dazed-16/Tactile/BOM.md

# Tactile – bill of materials

<!-- Generated by Half Life from project cmuvi96ii00q001opnk86sqve. Edits here are overwritten on the next sync. -->
<!-- Generated: 2026-10-12T03:10:27.600Z -->

> [!NOTE]
> This parts list is mirrored from [Half Life](https://halflife.hackclub.com). Editing it here will not change the platform's copy, and the next sync overwrites this file.

| Week | Tier | Parts funding |
| --- | --- | --- |
| Week 1 | Tier 2 | $65.00 |

| Part | What it's for | Qty | Unit | Total | Vendor |
| --- | --- | --- | --- | --- | --- |
| [BLE controller](https://www.seeedstudio.com/Seeed-XIAO-BLE-nRF52840-p-5201.html) | — | 1 | $9.90 | $9.90 | [Seeedstudio](https://www.seeedstudio.com/Seeed-XIAO-BLE-nRF52840-p-5201.html) |
| [Tactile switches](https://en.akkogear.com/product/creamy-purple-u1-switch/) | — | 2 | $9.99 | $19.98 | [Akkogear](https://en.akkogear.com/product/creamy-purple-u1-switch/) |
| [Touchpad](https://www.mouser.com/en/ProductDetail/Cirque/TM040040-2024-302?qs=wd5RIQLrsJgMzmw571gvDw%3D%3D) | — | 1 | $9.63 | $9.63 | [Mouser](https://www.mouser.com/en/ProductDetail/Cirque/TM040040-2024-302?qs=wd5RIQLrsJgMzmw571gvDw%3D%3D) |
| [Matrix diodes](https://www.digikey.com/en/products/detail/diodes-incorporated/1N4148W-7-F/815280) | — | 100 | $0.07 | $7.00 | [DigiKey](https://www.digikey.com/en/products/detail/diodes-incorporated/1N4148W-7-F/815280) |
| [Shift registers](https://www.digikey.com/en/products/detail/nexperia-usa-inc/74HC595D-118/763394) | — | 2 | $0.30 | $0.60 | [DigiKey](https://www.digikey.com/en/products/detail/nexperia-usa-inc/74HC595D-118/763394) |
| [Capacitors](https://www.digikey.com/en/products/detail/yageo/CC0805KRX7R9BB104/302874) | — | 10 | $0.10 | $1.00 | [DigiKey](https://www.digikey.com/en/products/detail/yageo/CC0805KRX7R9BB104/302874) |
| [Touchpad connector](https://www.digikey.com/en/products/detail/hirose-electric-co-ltd/FH12-12S-0-5SH-55/1110316) | — | 1 | $2.00 | $2.00 | [DigiKey](https://www.digikey.com/en/products/detail/hirose-electric-co-ltd/FH12-12S-0-5SH-55/1110316) |
| [Touchpad cable](https://www.digikey.com/en/products/detail/assmann-wsw-components/AFFC-050-12-051-11/6570261) | — | 1 | $2.00 | $2.00 | [DigiKey](https://www.digikey.com/en/products/detail/assmann-wsw-components/AFFC-050-12-051-11/6570261) |
| [Ribbon cable](https://www.digikey.com/en/products/detail/assmann-wsw-components/AWG28-14-F-300/655738) | — | 2 | $1.79 | $3.58 | [DigiKey](https://www.digikey.com/en/products/detail/assmann-wsw-components/AWG28-14-F-300/655738) |
| [IDC sockets](https://www.digikey.com/en/products/detail/assmann-wsw-components/AWP-14-8240-T/5244612) | — | 2 | $0.60 | $1.20 | [DigiKey](https://www.digikey.com/en/products/detail/assmann-wsw-components/AWP-14-8240-T/5244612) |
| [IDC strain reliefs](https://www.digikey.com/en/products/base-product/assmann-wsw-components/123/AWZ/567962) | — | 2 | $0.10 | $0.20 | [DigiKey](https://www.digikey.com/en/products/base-product/assmann-wsw-components/123/AWZ/567962) |
| [IDC headers](https://www.digikey.com/en/products/detail/assmann-wsw-components/AWHW-14G-0202-T/5224931) | — | 2 | $0.63 | $1.26 | [DigiKey](https://www.digikey.com/en/products/detail/assmann-wsw-components/AWHW-14G-0202-T/5224931) |
| [Power switch](https://www.digikey.com/en/products/detail/e-switch/EG1218/101726) | — | 1 | $0.72 | $0.72 | [DigiKey](https://www.digikey.com/en/products/detail/e-switch/EG1218/101726) |
| [Battery protection IC](https://www.ti.com/product/BQ2970) | — | 1 | $1.00 | $1.00 | [TI](https://www.ti.com/product/BQ2970) |
| [Dual MOSFET](https://www.ti.com/product/CSD83325L) | — | 1 | $1.50 | $1.50 | [TI](https://www.ti.com/product/CSD83325L) |
| 330 ohm resistor | — | 1 | $0.10 | $0.10 | — |
| 2.2 kOhm resistor | — | 1 | $0.10 | $0.10 | — |
| [Battery connector](https://www.jst-mfg.com/product/index.php?series=ACH) | — | 1 | $0.50 | $0.50 | [Jst-mfg](https://www.jst-mfg.com/product/index.php?series=ACH) |
| **Parts subtotal** | — | — | — | **$62.27** | — |
| **Tax & shipping** | — | — | — | **$0.00** | — |
| **Total** | — | — | — | **$62.27** | — |

$2.73 left of the tier's funding.
