dazed-16/Tactile/Tactile/Model/Leftside.stl

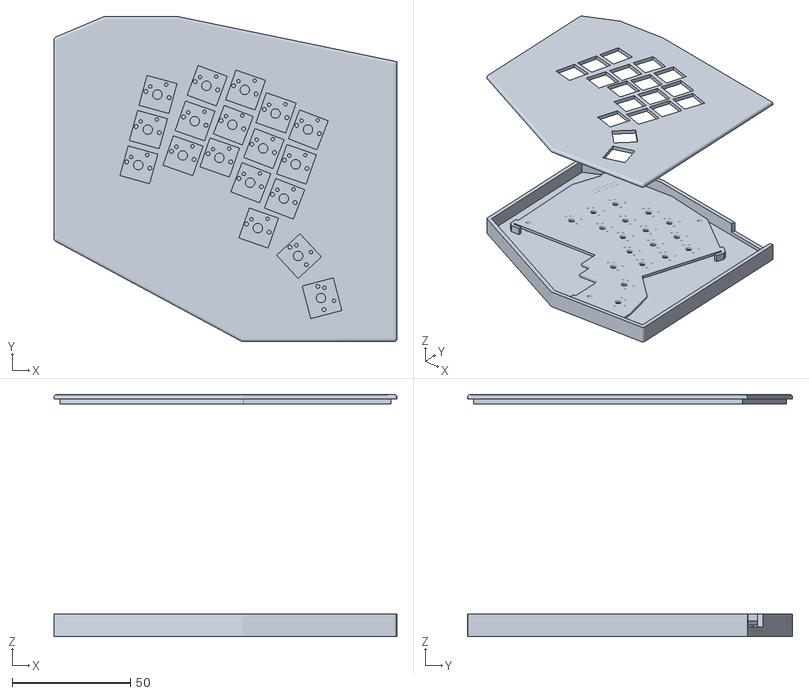
[picture p6: CAD file, 2026-10-12]
Tactile/Model/Leftside.stl
145.2 x 137.6 x 102.5
