dazed-16/Tactile/Tactile/Model/Right side.stl

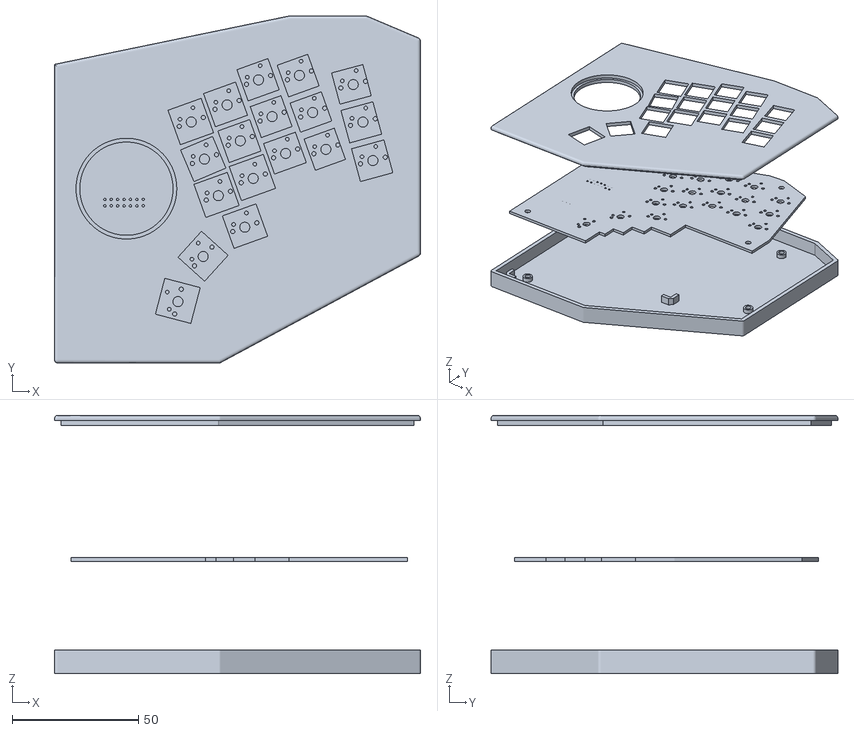
[picture p7: CAD file, 2026-10-12]
Tactile/Model/Right side.stl
145.2 x 137.6 x 102.5
