dazed-16/Tactile/Tactile/PCB/Left side/Tactile-l.kicad_pcb

## KiCad design Tactile/PCB/Left side/Tactile-l.kicad_pcb (2026-10-12)

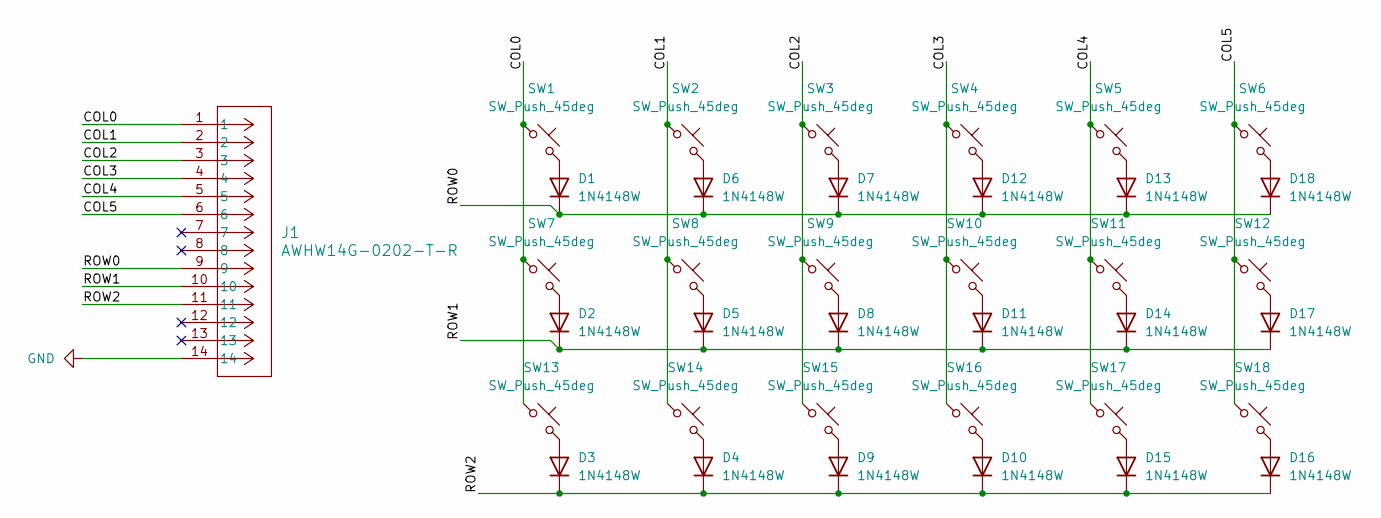
[picture p8: schematic Tactile-l.kicad_sch]

Parts:
D1, D2, D3, D4, D5, D6, D7, D8, D9, D10, D11, D12, D13, D14, D15, D16, D17, D18: 1N4148W; D_SOD-123
J1: AWHW14G-0202-T-R; CONN_AWHW14G-0x02-T_ASM
SW1, SW2, SW3, SW4, SW5, SW6, SW7, SW8, SW9, SW10, SW11, SW12, SW13, SW14, SW15, SW16, SW17, SW18: SW_Push_45deg; Knowles_SPH0645LM4H-6_3.5x2.65mm

Connections:
/COL0: J1.1, SW1.1, SW7.1, SW13.1
/COL1: J1.2, SW2.1, SW8.1, SW14.1
/COL2: J1.3, SW3.1, SW9.1, SW15.1
/COL3: J1.4, SW4.1, SW10.1, SW16.1
/COL4: J1.5, SW5.1, SW11.1, SW17.1
/COL5: J1.6, SW6.1, SW12.1, SW18.1
/ROW0: D1.1 (K), D6.1 (K), D7.1 (K), D12.1 (K), D13.1 (K), D18.1 (K), J1.9
/ROW1: D2.1 (K), D5.1 (K), D8.1 (K), D11.1 (K), D14.1 (K), D17.1 (K), J1.10
/ROW2: D3.1 (K), D4.1 (K), D9.1 (K), D10.1 (K), D15.1 (K), D16.1 (K), J1.11
GND: J1.14
unnamed: D1.2 (A), SW1.2
unnamed: D2.2 (A), SW7.2
unnamed: D3.2 (A), SW13.2
unnamed: D4.2 (A), SW14.2
unnamed: D5.2 (A), SW8.2
unnamed: D6.2 (A), SW2.2
unnamed: D7.2 (A), SW3.2
unnamed: D8.2 (A), SW9.2
unnamed: D9.2 (A), SW15.2
unnamed: D10.2 (A), SW16.2
unnamed: D11.2 (A), SW10.2
unnamed: D12.2 (A), SW4.2
unnamed: D13.2 (A), SW5.2
unnamed: D14.2 (A), SW11.2
unnamed: D15.2 (A), SW17.2
unnamed: D16.2 (A), SW18.2
unnamed: D17.2 (A), SW12.2
unnamed: D18.2 (A), SW6.2

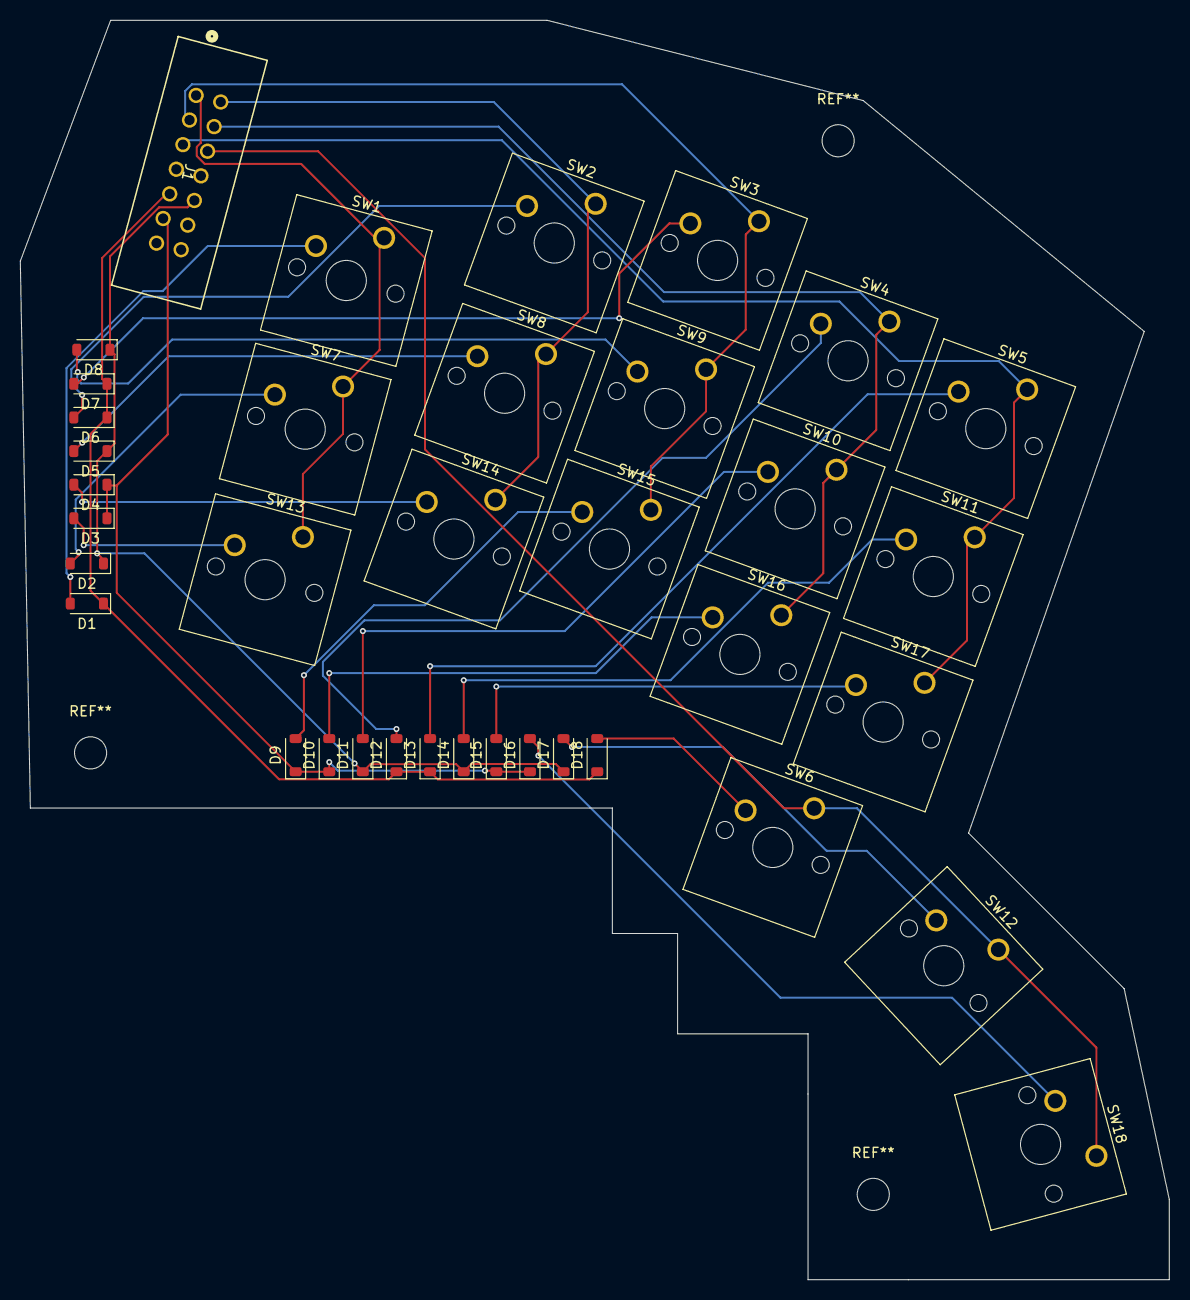
[picture p9: board Tactile-l.kicad_pcb from above]

Board: 2 copper layers, 114.5 x 125.5 mm, 37 parts (0 on the bottom side), 27 nets.
