dazed-16/Tactile/Tactile/PCB/Right side/Tactile-r.kicad_pcb

## KiCad design Tactile/PCB/Right side/Tactile-r.kicad_pcb (2026-10-12)

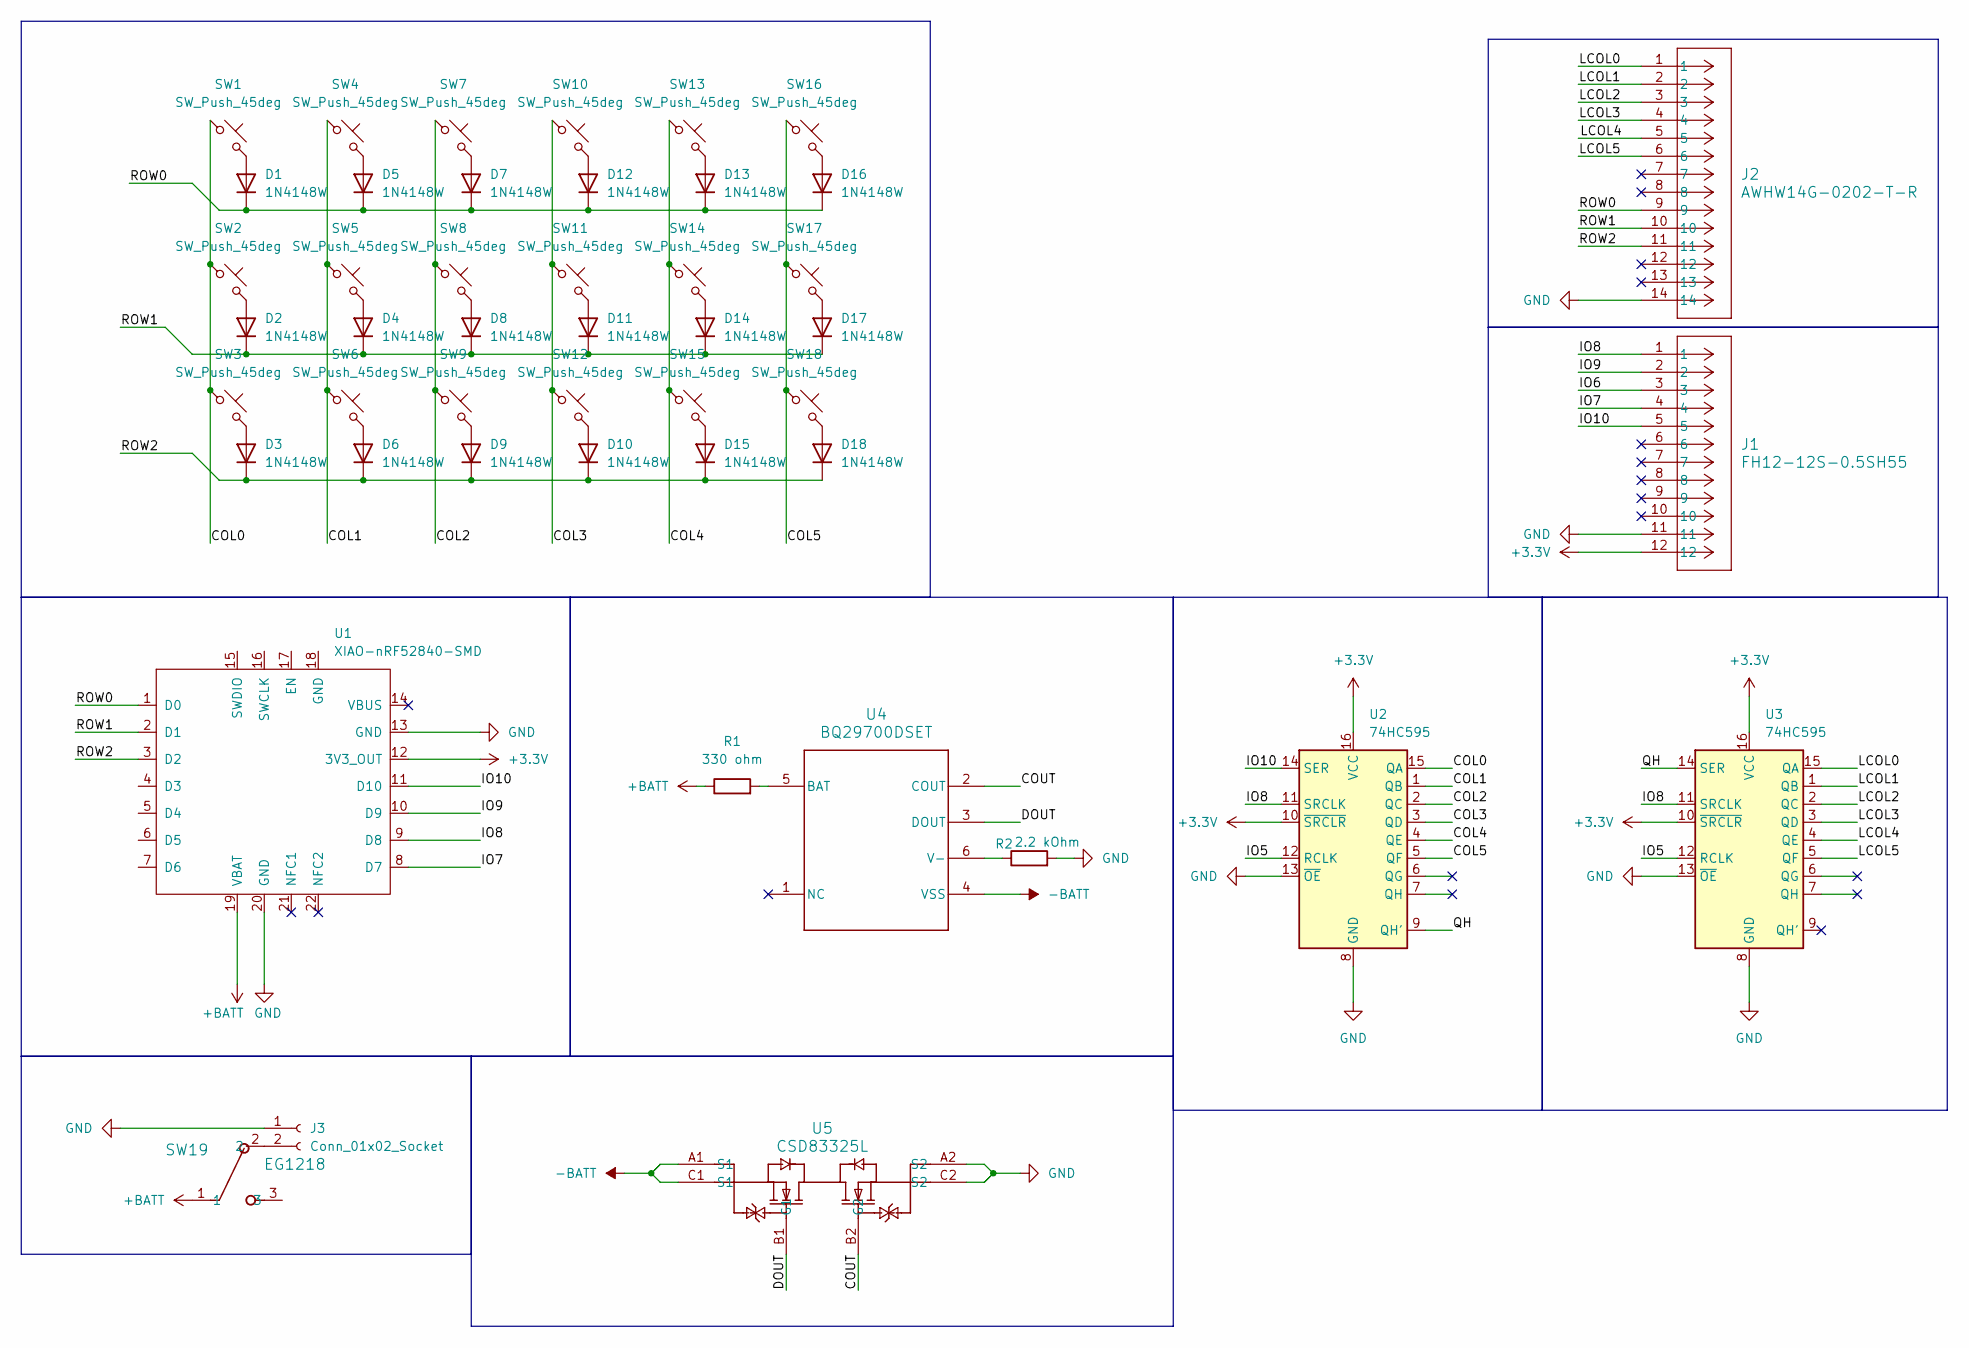
[picture p10: schematic Tactile-r.kicad_sch]

Parts:
D1, D2, D3, D4, D5, D6, D7, D8, D9, D10, D11, D12, D13, D14, D15, D16, D17, D18: 1N4148W; D_SOD-123
J1: FH12-12S-0.5SH55; CONN_FH12-12S-0.5SH55_HIR
J2: AWHW14G-0202-T-R; CONN_AWHW14G-0x02-T_ASM
J3: Conn_01x02_Socket; JST_ACH_BM02B-ACHSS-GAN-ETF_1x02-1MP_P1.20mm_Vertical
R1: 330 ohm; R_0603_1608Metric
R2: 2.2 kOhm; R_0603_1608Metric
SW1, SW2, SW3, SW4, SW5, SW6, SW7, SW8, SW9, SW10, SW11, SW12, SW13, SW14, SW15, SW16, SW17, SW18: SW_Push_45deg; SW_Cherry_MX_1.00u_PCB
SW19: EG1218; SW_1218_EWI
U1: XIAO-nRF52840-SMD; XIAO-nRF54LM20A-SMD
U2, U3: 74HC595; SSOP-16_5.3x6.2mm_P0.65mm
U4: BQ29700DSET; DSE0006A
U5: CSD83325L; YJE0006A

Connections:
+3.3V: J1.12, U1.12 (3V3_OUT), U2.10 (~SRCLR), U2.16 (VCC), U3.10 (~SRCLR), U3.16 (VCC)
+BATT: R1.1, SW19.1, U1.19 (VBAT)
-BATT: U4.4 (VSS), U5.A1 (S1), U5.C1 (S1)
/<NO NET>: J2.3, U3.2 (QC)
/COL0: SW1.1, SW2.1, SW3.1, U2.15 (QA)
/COL1: SW4.1, SW5.1, SW6.1, U2.1 (QB)
/COL2: SW7.1, SW8.1, SW9.1, U2.2 (QC)
/COL3: SW10.1, SW11.1, SW12.1, U2.3 (QD)
/COL4: SW13.1, SW14.1, SW15.1, U2.4 (QE)
/COL5: SW16.1, SW17.1, SW18.1, U2.5 (QF)
/COUT: U4.2 (COUT), U5.B2 (G2)
/DOUT: U4.3 (DOUT), U5.B1 (G1)
/IO5: U2.12 (RCLK), U3.12 (RCLK)
/IO6: J1.3
/IO7: J1.4, U1.8 (D7)
/IO8: J1.1, U1.9 (D8), U2.11 (SRCLK), U3.11 (SRCLK)
/IO9: J1.2, U1.10 (D9)
/IO10: J1.5, U1.11 (D10), U2.14 (SER)
/LCOL0: J2.1, U3.15 (QA)
/LCOL1: J2.2, U3.1 (QB)
/LCOL3: J2.4, U3.3 (QD)
/LCOL4: J2.5, U3.4 (QE)
/LCOL5: J2.6, U3.5 (QF)
/QH: U2.9 (QH'), U3.14 (SER)
/ROW0: D1.1 (K), D5.1 (K), D7.1 (K), D12.1 (K), D13.1 (K), D16.1 (K), J2.9, U1.1 (D0)
/ROW1: D2.1 (K), D4.1 (K), D8.1 (K), D11.1 (K), D14.1 (K), D17.1 (K), J2.10, U1.2 (D1)
/ROW2: D3.1 (K), D6.1 (K), D9.1 (K), D10.1 (K), D15.1 (K), D18.1 (K), J2.11, U1.3 (D2)
GND: J1.11, J2.14, J3.1, R2.2, U1.13 (GND), U1.20 (GND), U2.8 (GND), U2.13 (~OE), U3.8 (GND), U3.13 (~OE), U5.A2 (S2), U5.C2 (S2)
unnamed: D1.2 (A), SW1.2
unnamed: D2.2 (A), SW2.2
unnamed: D3.2 (A), SW3.2
unnamed: D4.2 (A), SW5.2
unnamed: D5.2 (A), SW4.2
unnamed: D6.2 (A), SW6.2
unnamed: D7.2 (A), SW7.2
unnamed: D8.2 (A), SW8.2
unnamed: D9.2 (A), SW9.2
unnamed: D10.2 (A), SW12.2
unnamed: D11.2 (A), SW11.2
unnamed: D12.2 (A), SW10.2
unnamed: D13.2 (A), SW13.2
unnamed: D14.2 (A), SW14.2
unnamed: D15.2 (A), SW15.2
unnamed: D16.2 (A), SW16.2
unnamed: D17.2 (A), SW17.2
unnamed: D18.2 (A), SW18.2
unnamed: J3.2, SW19.2
unnamed: R1.2, U4.5 (BAT)
unnamed: R2.1, U4.6 (V-)

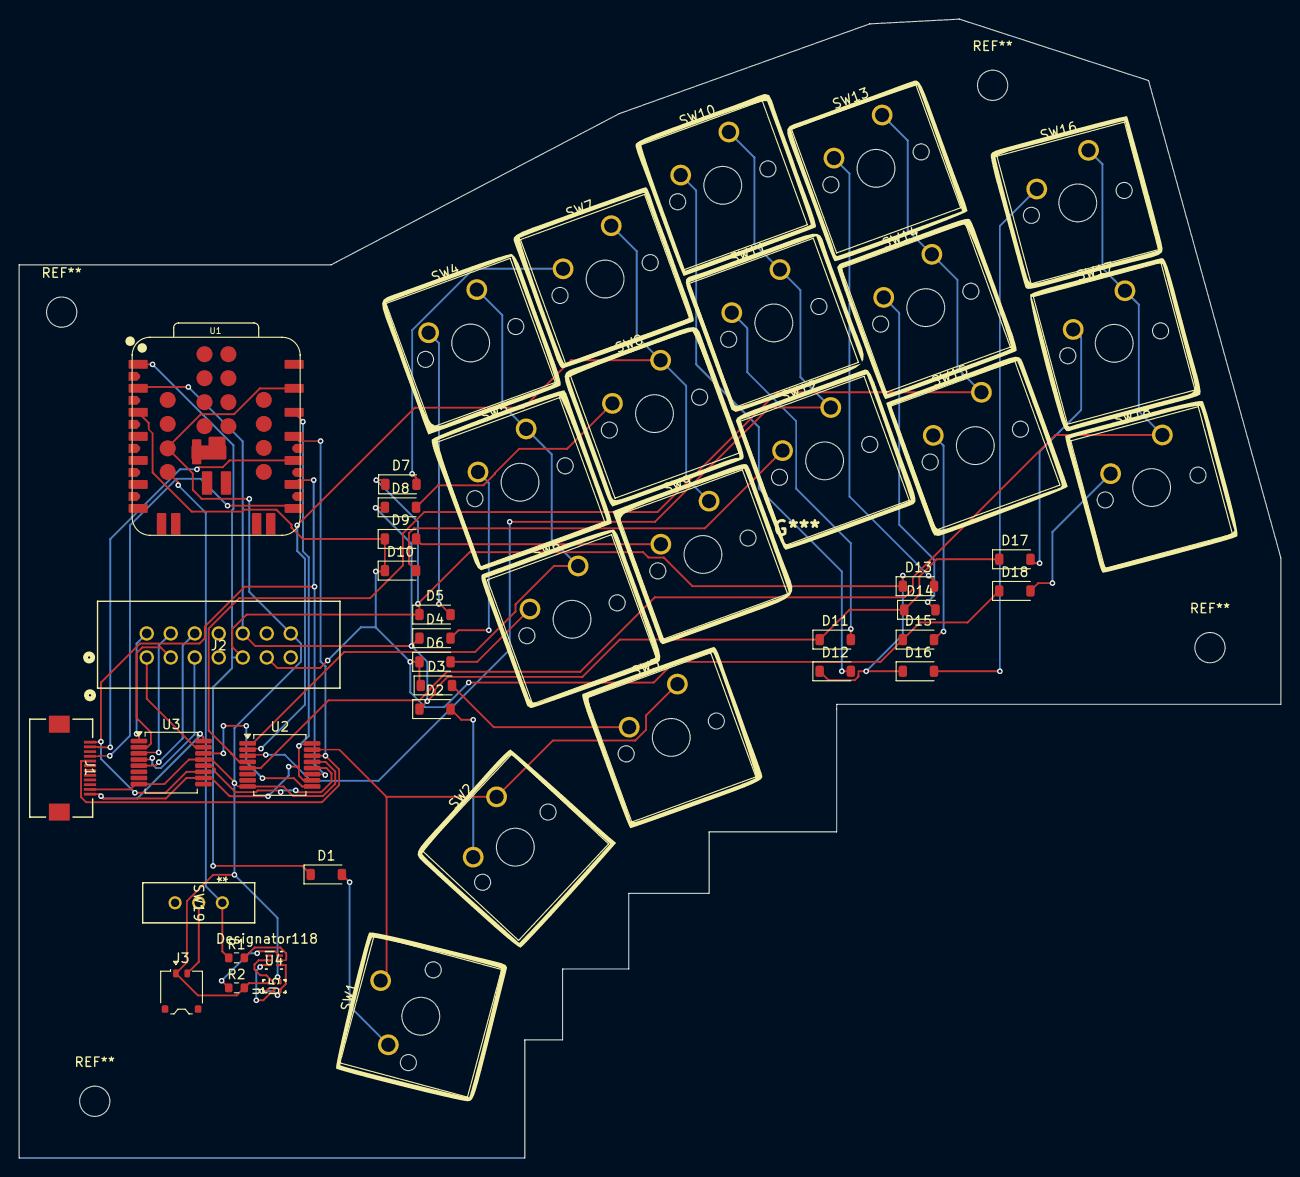
[picture p11: board Tactile-r.kicad_pcb from above]

Board: 2 copper layers, 133.5 x 120.5 mm, 47 parts (0 on the bottom side), 48 nets.
