dazed-16/Tactile/JOURNAL.md

# Tactile – devlog

<!-- Generated by Half Life from project cmuvi96ii00q001opnk86sqve. Edits here are overwritten on the next sync. -->
<!-- Generated: 2026-10-12T02:54:46.351Z -->

> [!NOTE]
> This devlog is mirrored from [Half Life](https://halflife.hackclub.com). Editing it here will not change the platform's copy, and the next sync overwrites this file.

> Tactile is a custom split mechanical keyboard for programming, live coding and CAD, with a thumb touchpad for pointer control.

| Week | Tier | Hours logged | Entries |
| --- | --- | --- | --- |
| Week 1 | Tier 2 | 14h | 6 |

## Contents

1. [2026-10-07 – # JOURNAL NUM1!!!!!](#2026-10-07-journal-num1)
2. [2026-10-08 – # CHECKPOINT NUM 2!!!!](#2026-10-08-checkpoint-num-2)
3. [2026-10-10 – # CHECKPOINT 3!!!!!!!!!](#2026-10-10-checkpoint-3)
4. [2026-10-11 – # CHECKPOINT NUM 4](#2026-10-11-checkpoint-num-4)
5. [2026-10-11 – # CHECKPOINT NUM 5](#2026-10-11-checkpoint-num-5)
6. [2026-10-11 – # LAST ONE!](#2026-10-11-last-one)

## Design

### 2026-10-07 – # JOURNAL NUM1!!!!!

**2h**

# JOURNAL NUM1!!!!!
Ok so kind of late to the party since school is just getting bussy, but here is a little overview of what I did here.
+ I rounded my price point to 65$ as a starting point
+ Generated a few of the components
+ Chose a few components that are economically viable

Ok so the real issue here is price of hour works, since I dont think I can do 20 hours in these 4 days, I might be able to undo a few of my ideas to the "essence" of the project. This includes, split keyboard, mouse integrated, and clicky keycaps. I also designed a nice setup for my hands!

bom

keyboard

### 2026-10-08 – # CHECKPOINT NUM 2!!!!

**2h**

# CHECKPOINT NUM 2!!!!
Okay so this is half of the keyboard done I chose the layout that seemed most attractive and comfortable, for me, I also made the schematic and PCB, of the left half, on checkpoint one I planned the most budget friendly option. Here is what I did today!
+ Chose keyboard layout
+ Schematic of left side
+ PCB of left side

I designed so the left side pretty much just connects like a controller to the right side, the right side has the battery, micro controller and usb connection so that will take me longer.

check1

### What I had problems with?
Its my first time making a keyboard, not only the format so I had some trouble working the footprints and silkscreen but I think it looks good, I am also going to see if someone can help me design a few mounting holes for the pcb since Ive never done accurate edgecuts apart from a simple cube

left

### 2026-10-10 – # CHECKPOINT 3!!!!!!!!!

**3h**

# CHECKPOINT 3!!!!!!!!!
Okay so the right side is FINALLY FINISHED, it took SOOOOOOOOOOOOOOOOOOOOOOOOO long, I swear I feel like im cutting myself short just logging 3 hours, but anyways, everything has been finished, and I am working on the documentation.

check3
## What I did today
+ Researched requirements for the left side (budget version)
+ Made schematic
+ Made PCB
+ Made documentation and updated BOM

check4
### What I struggled with?
Honestly it was a bit of a smooth ride now that I am getting the hang of making the keyboard, but the documentation was super crazy, some parts were way too expensive for the 13 hour goal I had, so I modified the plan to use the parts that I have on hand.

check5

### 2026-10-11 – # CHECKPOINT NUM 4

**4h**

# CHECKPOINT NUM 4
Okayyyyyy this was a big one, I made a lot of changes including the pcb, model and now 3d printed encasing?!?!?!?!? Yes you heard me this is what I did!
+ Modified edgecuts
+ Made 3d model
+ Made encasing
+ Tested,reiterated, repeated

check4

right side3
## What I strugled with?
I had some issues since its been so long since ive used, onshape, same thing with the edgecuts I dont like the geometry at all, it is kinda all over the place

rightside2
### What I might change?
In the future I might change the edgecuts and make the casing better.

right side

### 2026-10-11 – # CHECKPOINT NUM 5

**2h**

# CHECKPOINT NUM 5
Just finished the left side time is running out now is the sprint to finish!
+ Finished changing the left side
+ Finished making the case on the left side.



### What will probably change later
In the future I need to make the casing a lot nicer, but I have to finish NOW

leftside2

### 2026-10-11 – # LAST ONE!

**1h**

# LAST ONE!
Okay I just finished the full git repo, this include things I want to change, BOM, fab files, descriptions, instructions including a few markdowns for all you vibecoders out there! Now I will finish proyect num 1!!!!

repo

repo2
