dazed-16/Tactile/(commit log)

2026-10-07 first commit for pcb
2026-10-08 Added BOM
2026-10-12 Organize fabrication exports and add Gerber packages
2026-10-12 Clarify BOM unit prices and include shipping and tax charges
